needbmw/icarus2/BOM/ica2_BOM.xls

 | * - только Тип "А", ** - только Тип "Б", *** - вообще не устанавливать
Comment | Designator | Footprint | Quantity | Кол-во Тип "А" | Кол-во Тип "Б"
0.47uF | C1_C11, C1_C12, C1_C21, C1_C22, C1_C31, C1_C32, C1_C41, C1_C42, C1_C51, C1_C52, C1_C61, C1_C62, C1_C71, C1_C72, C1_C81, C1_C82, C1_C91, C1_C92, C1_C101, C1_C102, C2*, C3*, C5_C11, C5_C12, C5_C21, C5_C22, C5_C31, C5_C32, C5_C41, C5_C42, C5_C51, C5_C52, C5_C61, C5_C62, C5_C71, C5_C72, C5_C81, C5_C82, C5_C91, C5_C92, C5_C101, C5_C102, C6_C11, C6_C12, C6_C21, C6_C22, C6_C31, C6_C32, C6_C41, C6_C42, C6_C51, C6_C52, C6_C61, C6_C62, C6_C71, C6_C72, C6_C81, C6_C82, C6_C91, C6_C92, C6_C101, C6_C102, C13_C11, C13_C12, C13_C21, C13_C22, C13_C31, C13_C32, C13_C41, C13_C42, C13_C51, C13_C52, C13_C61, C13_C62, C13_C71, C13_C72, C13_C81, C13_C82, C13_C91, C13_C92, C13_C101, C13_C102, C17_C11, C17_C12, C17_C21, C17_C22, C17_C31, C17_C32, C17_C41, C17_C42, C17_C51, C17_C52, C17_C61, C17_C62, C17_C71, C17_C72, C17_C81, C17_C82, C17_C91, C17_C92, C17_C101, C17_C102, C18_C11, C18_C12, C18_C21, C18_C22, C18_C31, C18_C32, C18_C41, C18_C42, C18_C51, C18_C52, C18_C61, C18_C62, C18_C71, C18_C72, C18_C81, C18_C82, C18_C91, C18_C92, C18_C101, C18_C102, C25_C11, C25_C12, C25_C21, C25_C22, C25_C31, C25_C32, C25_C41, C25_C42, C25_C51, C25_C52, C25_C61, C25_C62, C25_C71, C25_C72, C25_C81, C25_C82, C25_C91, C25_C92, C25_C101, C25_C102, C29_C11, C29_C12, C29_C21, C29_C22, C29_C31, C29_C32, C29_C41, C29_C42, C29_C51, C29_C52, C29_C61, C29_C62, C29_C71, C29_C72, C29_C81, C29_C82, C29_C91, C29_C92, C29_C101, C29_C102, C33_C11, C33_C12, C33_C21, C33_C22, C33_C31, C33_C32, C33_C41, C33_C42, C33_C51, C33_C52, C3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 | CAPC1608L (0603) | 267 | 267 | 248
0.22 | C4_P11, C4_P12, C7_P11, C7_P12, C8_P11, C8_P12, C9_P11, C9_P12, C10_P11, C10_P12, C11_P11, C11_P12, C12_P11, C12_P12, C14_P11, C14_P12, C15_P11, C15_P12, C16_P11, C16_P12 | C1206 | 20 | 20 | 20
270uF/16V | C124* | CAP8X8 | 1 | 1 | 0
22uF | C125*, C128* | CAPC3225N (1210) | 2 | 2 | 0
4.7uF | C126*, C127* | CAPC2012L | 2 | 2 | 0
CTANT | C144* | CC6032-TANTC | 1 | 1 | 0
22uF | C145*, C147*, C148*, C176_P11, C176_P12, C177_P11, C177_P12 | CAPC3216L | 7 | 7 | 4
4.7uF | C149*, C152*, C155*, C157_P11, C157_P12, C158_P11, C158_P12 | CAPC1608L | 7 | 7 | 4
0.47uF | C153* | RESC1608L | 1 | 1 | 0
680uF | C156***_P11, C156***_P12, C169_P11, C169_P12 | D | 4 | 2 | 2
10uF/16V | C159_P11, C159_P12 | CAPC3216L (1206) | 2 | 2 | 2
270uF/16V | C160_P11, C160_P12 | SANYO SVP E12 | 2 | 2 | 2
22uF/16V | C161_P11, C161_P12, C162_P11, C162_P12 | CAPC3225L (1210) | 4 | 4 | 4
4.7uF/16V | C163_P11, C163_P12, C164_P11, C164_P12, C173_P11, C173_P12 | CAPC2012L | 6 | 6 | 6
6800pF | C165_P11, C165_P12 | CAPC1608L (0603) | 2 | 2 | 2
1uF/20V | C166_P11, C166_P12 | CAPC1608L (0603) | 2 | 2 | 2
Cap Pol1 | C167_P11, C167_P12, C168_P11, C168_P12 | SANYO SVP F12 | 4 | 4 | 4
47uF | C170_P11, C170_P12 | CAPC3225L (1210) | 2 | 2 | 2
10uF | C171_P11, C171_P12, C174_P11, C174_P12 | CAPC2012L | 4 | 4 | 4
560pF | C172_P11, C172_P12 | CAPC1608L (0603) | 2 | 2 | 2
3900pF | C175_P11, C175_P12 | CAPC1608L (0603) | 2 | 2 | 2
GREEN LED | DONE*, LED1* | CD1608-0603 | 2 | 2 | 2
SMD2920P300TF/15 | F1_P11, F1_P12 | CC7451-2920 | 2 | 2 | 2
MF-MSMF030 0.3A | F2* | CC4532-1812 | 1 | 1 | 0
Header 4 | FAN1* | 4PINFAN | 1 | 1 | 0
TI 321611 U601 | FB1*, FB2*, FB3_P11, FB3_P12, FB4_P11, FB4_P12 | INDC3216L (1206) | 6 | 6 | 4
Header 6 | JTAG1*** | HDR1X6 | 1 | не уст. | не уст.
IHLP5050FDER | L1_P11, L1_P12 | IHLP5050 | 2 | 2 | 2
RED LED | LED2* | CD1608-0603 | 1 | 1 | 0
YELLOW LED | LED3*, LED4* | CD1608-0603 | 2 | 2 | 0
TB160808 U601 | M1_C11, M1_C12, M1_C21, M1_C22, M1_C31, M1_C32, M1_C41, M1_C42, M1_C51, M1_C52, M1_C61, M1_C62, M1_C71, M1_C72, M1_C81, M1_C82, M1_C91, M1_C92, M1_C101, M1_C102, R25*, R33*, M11 | RESC1608L (0603) | 23 | 23 | 21
09 02 164 2921 | P1** | 0902164x921 | 1 | 0 | 1
mini USB connector | P2* | MUBS1-05SN2 | 1 | 1 | 0
MOLEX 5569-08A2 | P3* | 5569-08A2 | 1 | 1 | 0
SW-PB | PROG1*** | SKQMA | 1 | не уст. | не уст.
PSMN2R2-25YLC | Q1*, Q2_P11, Q2_P12 | LFPAK | 3 | 3 | 2
NC | Q3_P11, Q3_P12 | LFPAK | 2 | 2 | 2
CSD16403Q5A | Q4_P11, Q4_P12, Q5_P11, Q5_P12 | LFPAK | 4 | 4 | 4
100K | R1_C11, R1_C12, R1_C21, R1_C22, R1_C31, R1_C32, R1_C41, R1_C42, R1_C51, R1_C52, R1_C61, R1_C62, R1_C71, R1_C72, R1_C81, R1_C82, R1_C91, R1_C92, R1_C101, R1_C102, R42_P11, R42_P12 | RESC1608L (0603) | 22 | 22 | 22
470R | R11_H0, R11_H1, R12_H0, R12_H1 | RESC1608L (0603) | 4 | 4 | 4
0R | R13_H0, R13_H1, R14_H0, R14_H1, R15, R35_P11, R35_P12, R38_P11, R38_P12 | RESC1608L (0603) | 9 | 9 | 9
4.7K | R16*, R20*, R21*, R22*, R31* | RESC1608L (0603) | 5 | 5 | 0
NC | R17*, R18*, R36_P11, R36_P12 | RESC1608L (0603) | 4 | не уст. | не уст.
100R | R19*, R28*, R30* | RESC1608L (0603) | 3 | 3 | 0
1.8K | R23*, R24* | RESC1608L (0603) | 2 | 2 | 0
MB* | R26 | RESC1608L (0603) | 1 | 1 | 1
510R | R27* | RESC1608L (0603) | 1 | 1 | 0
270R | R29* | RESC1608L (0603) | 1 | 1 | 0
0R | R34* | RESC1005L (0402) | 1 | 1 | 0
1K | R37_P11, R37_P12 | RESC1608L (0603) | 2 | 2 | 2
6.81K | R39_P11, R39_P12 | RESC1608L (0603) | 2 | 2 | 2
10K | R40_P11, R40_P12, R43_P11, R43_P12 | RESC1608L (0603) | 4 | 4 | 4
3.9K | R41_P11, R41_P12 | RESC1608L (0603) | 2 | 2 | 2
10.5K | R44_P11, R44_P12 | RESC1608L (0603) | 2 | 2 | 2
909R | R45_P11, R45_P12 | RESC1608L (0603) | 2 | 2 | 2
220R | RN1* | EXBV8V (4х0402) | 1 | 1 | 0
100R | RN2*, RN4*, RN5*, RN6* | EXBV8V (4х0402) | 4 | 4 | 0
4K7 | RN3* | EXBV8V (4х0402) | 1 | 1 | 0
NHDS-04 | S1* | WSOP8 | 1 | 1 | 0
ASIC | U1_C11, U1_C12, U1_C21, U1_C22, U1_C31, U1_C32, U1_C41, U1_C42, U1_C51, U1_C52, U1_C61, U1_C62, U1_C71, U1_C72, U1_C81, U1_C82, U1_C91, U1_C92, U1_C101, U1_C102 | QFN48NT7A | 20 | 20 | 20
SN74LVC2G34DBVR | U11_H0, U11_H1, U12_H0, U12_H1, U13_H0, U13_H1 | SOT23-6 | 6 | 6 | 6
XC6SLX9-2TQG144I | U14* | TQG144_N | 1 | 1 | 0
M25P40-VMN6PB | U15* | SO-G8 | 1 | 1 | 0
LM1086CS-3.3 | U16* | TS3B_M | 1 | 1 | 0
W25Q40BV | U17*** | WSOP8 | 1 | не уст. | не уст.
RT9166A_CXL_1V2 | U18*, U21_P11, U21_P12 | SOT-89_M | 3 | 3 | 2
FT232RQ-Tray | U19* | PQFN5X5-32_V_M | 1 | 1 | 0
TPS40193 | U20_P11, U20_P12 | SON10 | 2 | 2 | 2
XTAL_32M | Y1 | SMX2 | 1 | 1 | 1
