needbmw/icarus2/DWG/Drill.dxf

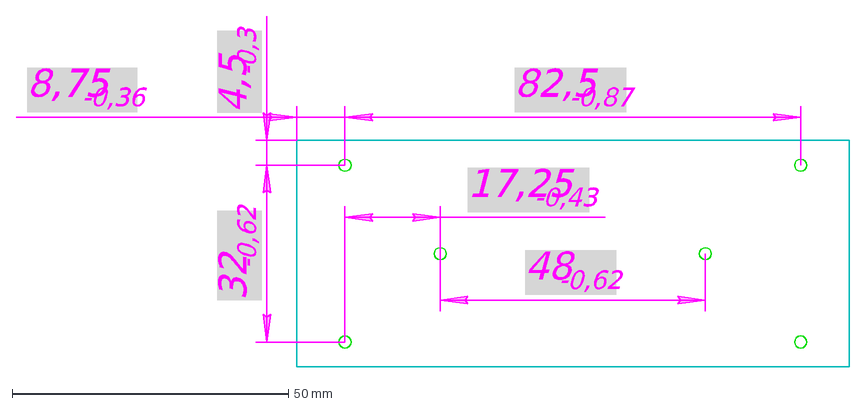
[picture p1: CAD file, 2013-11-19]
DWG/Drill.dxf
82,5
-0,87
32
-0,62
48
17,25
-0,43
4,5
-0,3
8,75
-0,36
