needbmw/icarus2/DWG/Heatsink.pdf

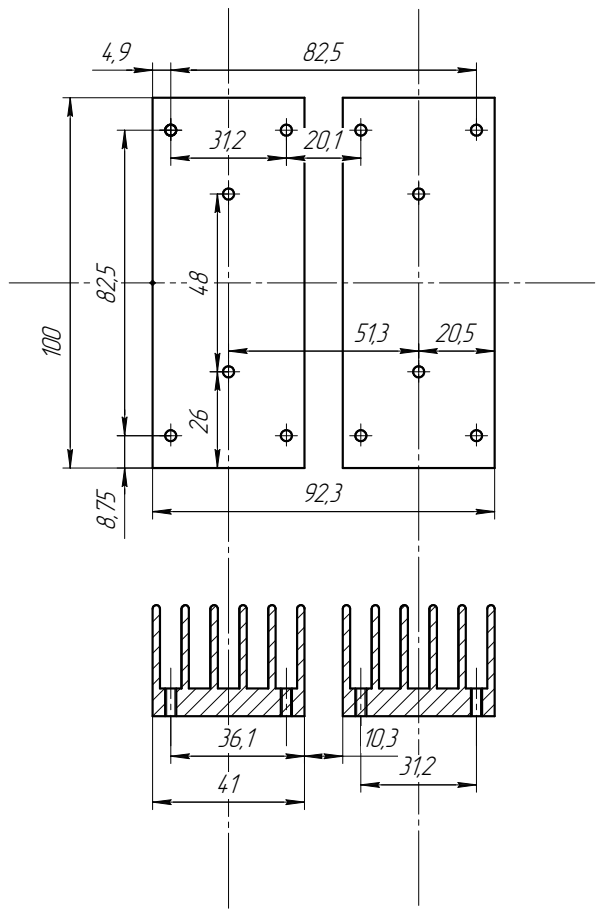
[picture p2: page 1]
