needbmw/icarus2/SCH/ica2.pdf

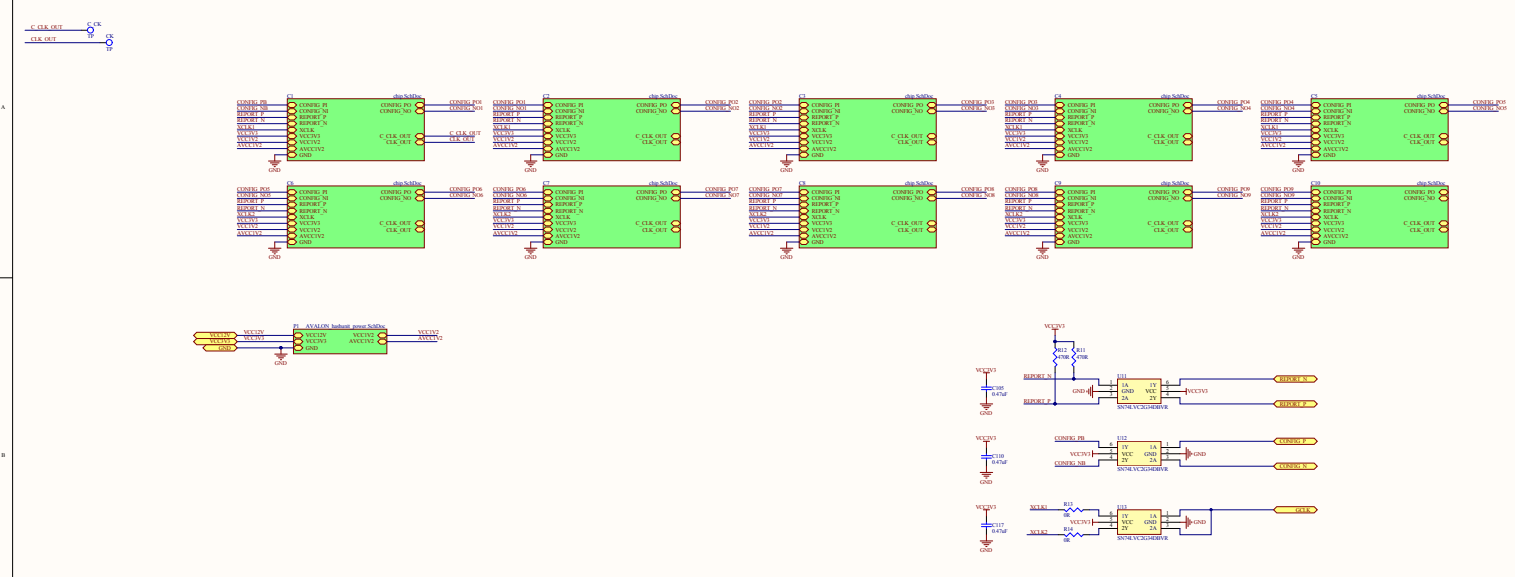
[picture p3: page 1]

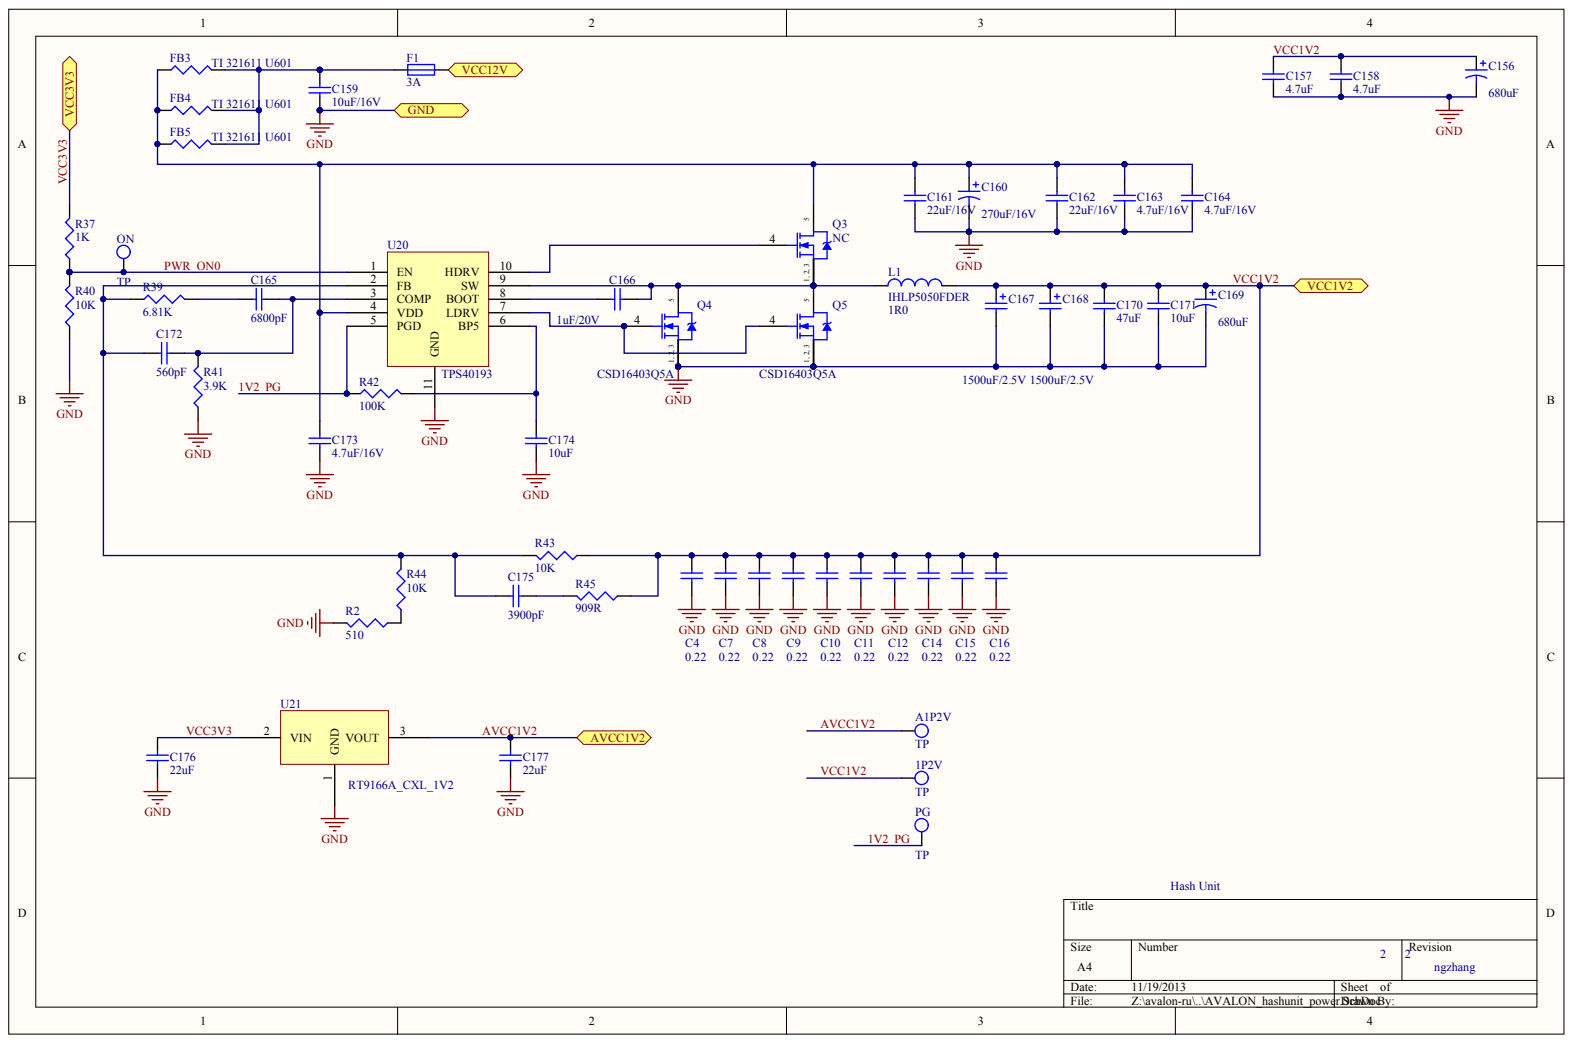
[picture p4: page 2]

TP C165 | | FB 2 | C166
R39 | | | | COMP 3
6.81K C172 | 6800pF | | | VDD 4

Size A4 | Number 2 | Revision 2 ngzhang

Date: 11/19/2013 | Sheet of
File: Z:\avalon-ru\..\AVALON_hashunit_power.SchDoc Drawn By:

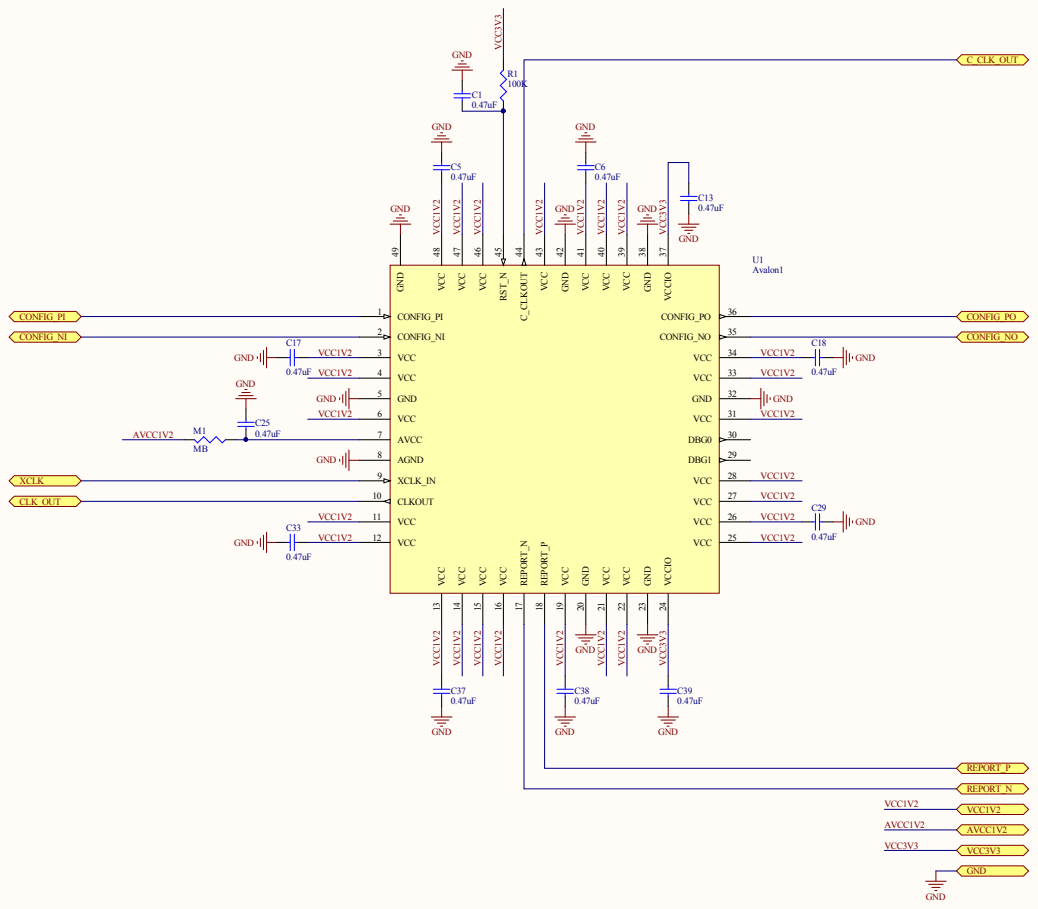
[picture p5: page 3]

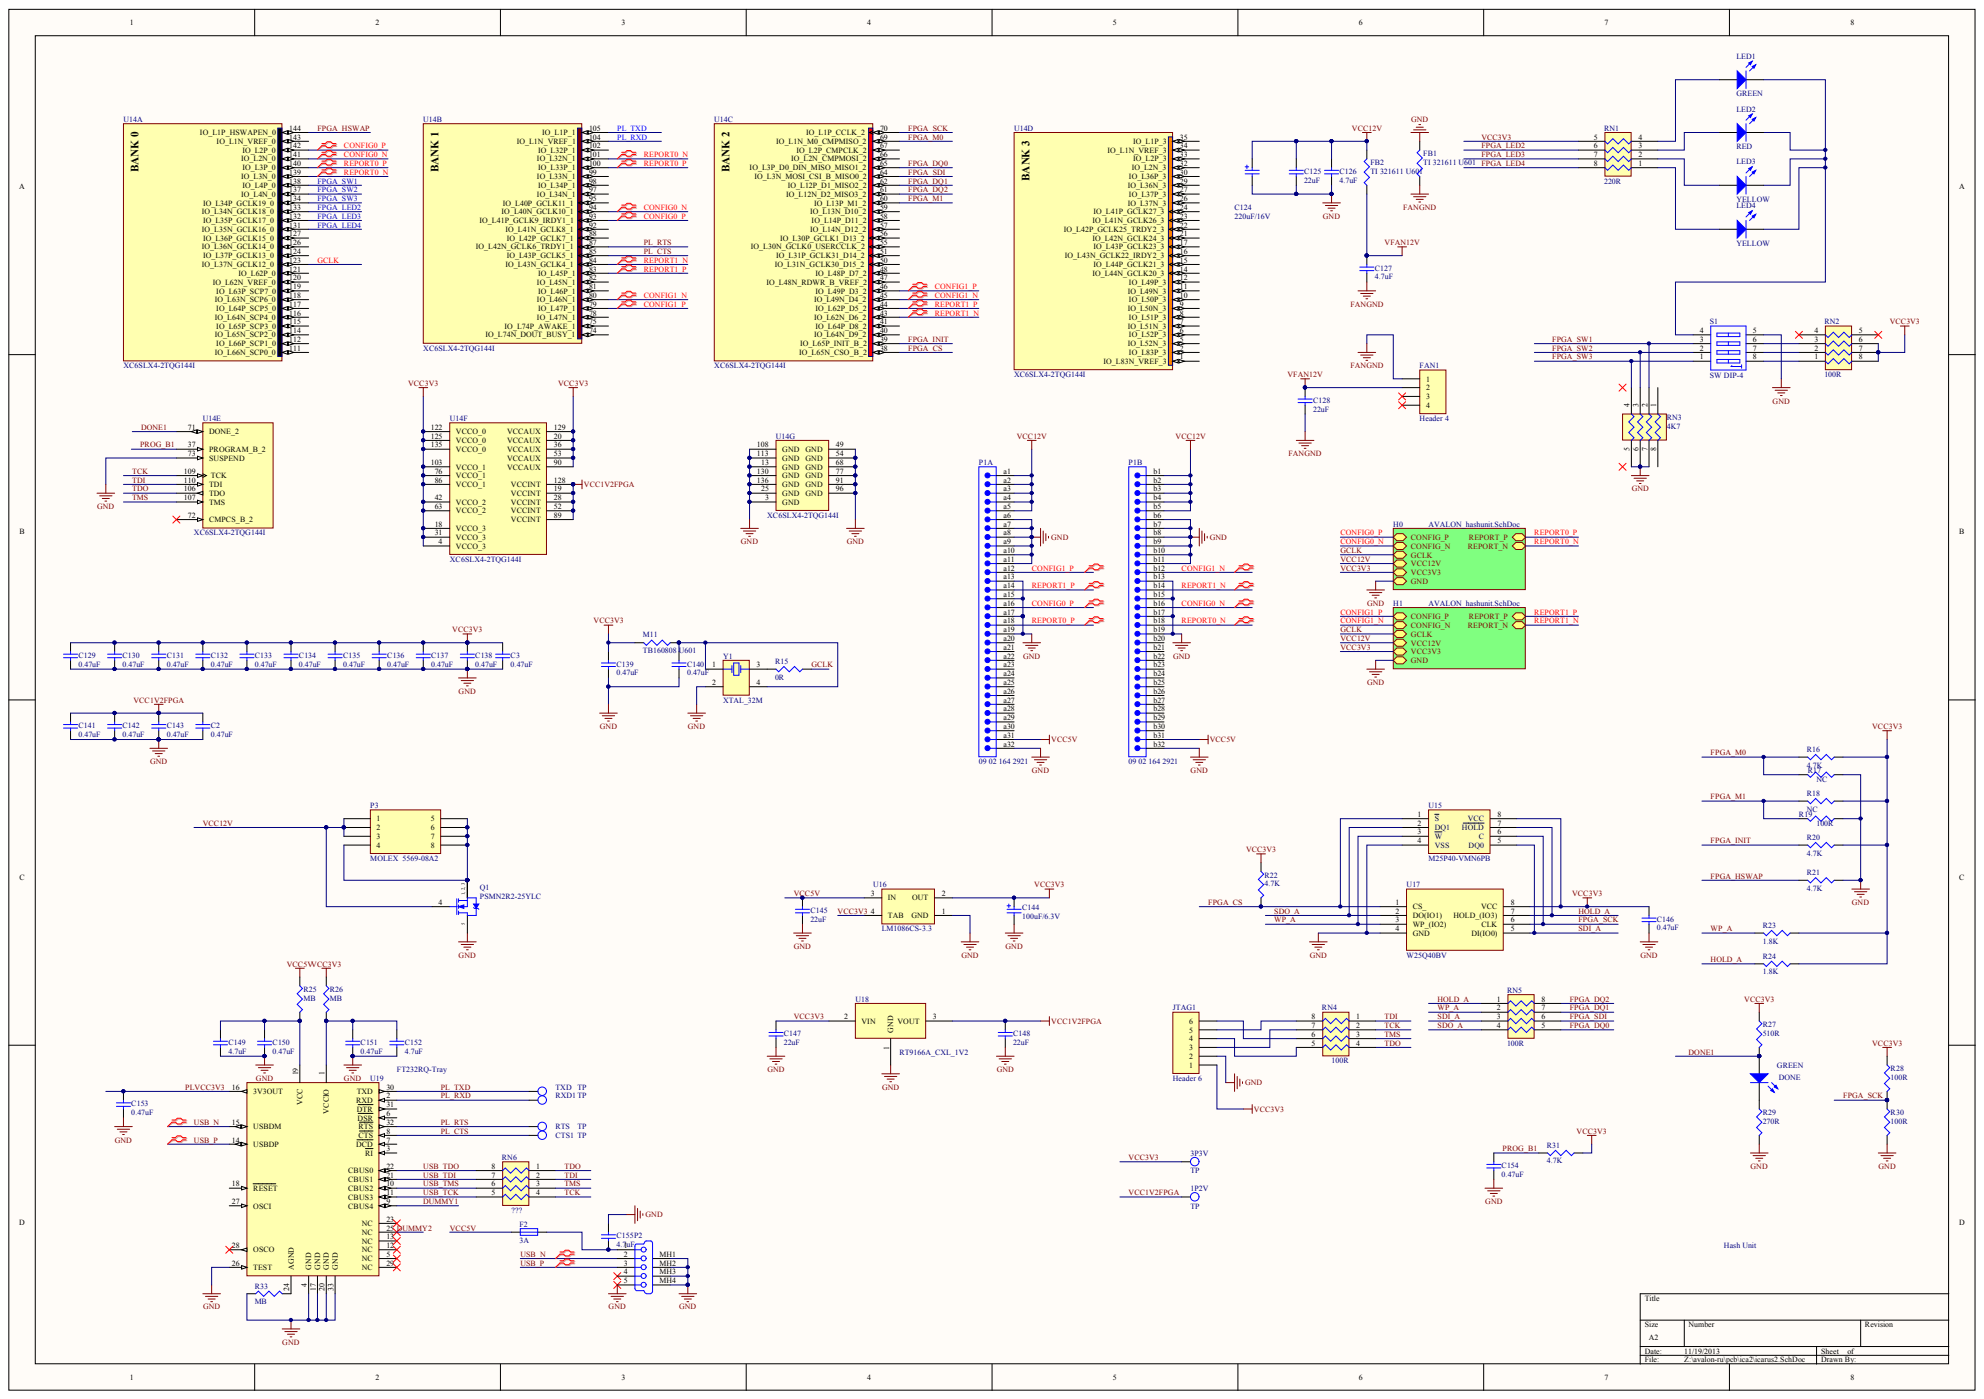
[picture p6: page 4]

FPGA_SCK
SDI_A

7 | 2 TCK SDO_A
6 | 3 TMS

MH2
MH3
